ykie-Wang/crkbd/corne-cherry-SMT/corne-smt-gerber/corne-cherry-Edge_Cuts.dxf

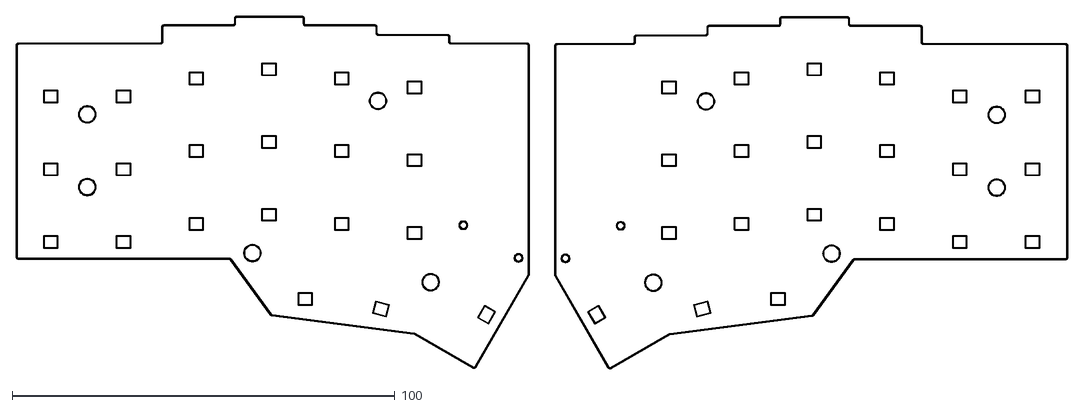
[picture p1: CAD file, 2024-04-05]
corne-cherry-SMT/corne-smt-gerber/corne-cherry-Edge_Cuts.dxf
274.7 x 92.1
