ykie-Wang/crkbd/corne-cherry-SMT/pcb/edges-for-wireless-cherry.dxf

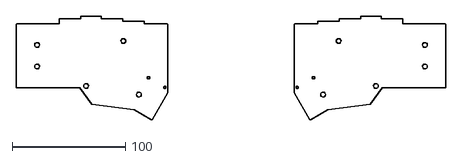
[picture p2: CAD file, 2023-12-01]
corne-cherry-SMT/pcb/edges-for-wireless-cherry.dxf
379.0 x 91.7
