ykie-Wang/crkbd/corne-cherry-SMT/pcb/right-edges-for-wireless-cherry.dxf

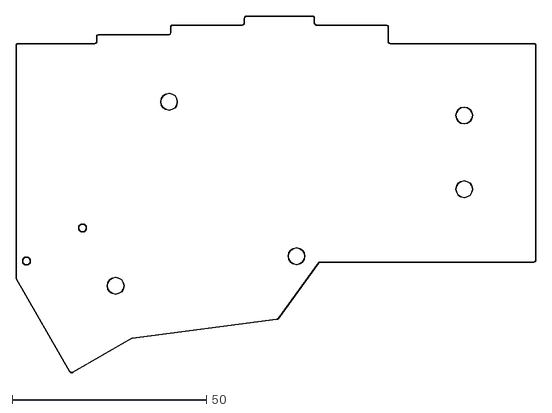
[picture p3: CAD file, 2023-12-01]
corne-cherry-SMT/pcb/right-edges-for-wireless-cherry.dxf
133.8 x 91.7
