ykie-Wang/crkbd/(list of files, cad)

Other CAD files:
corne-cherry-SMT/corne-smt-gerber/corne-cherry-F_Mask.dxf
