ykie-Wang/crkbd/corne-cherry-SMT/pcb/corne-cherry.kicad_pcb

## KiCad design corne-cherry-SMT/pcb/corne-cherry.kicad_pcb (2024-04-05)

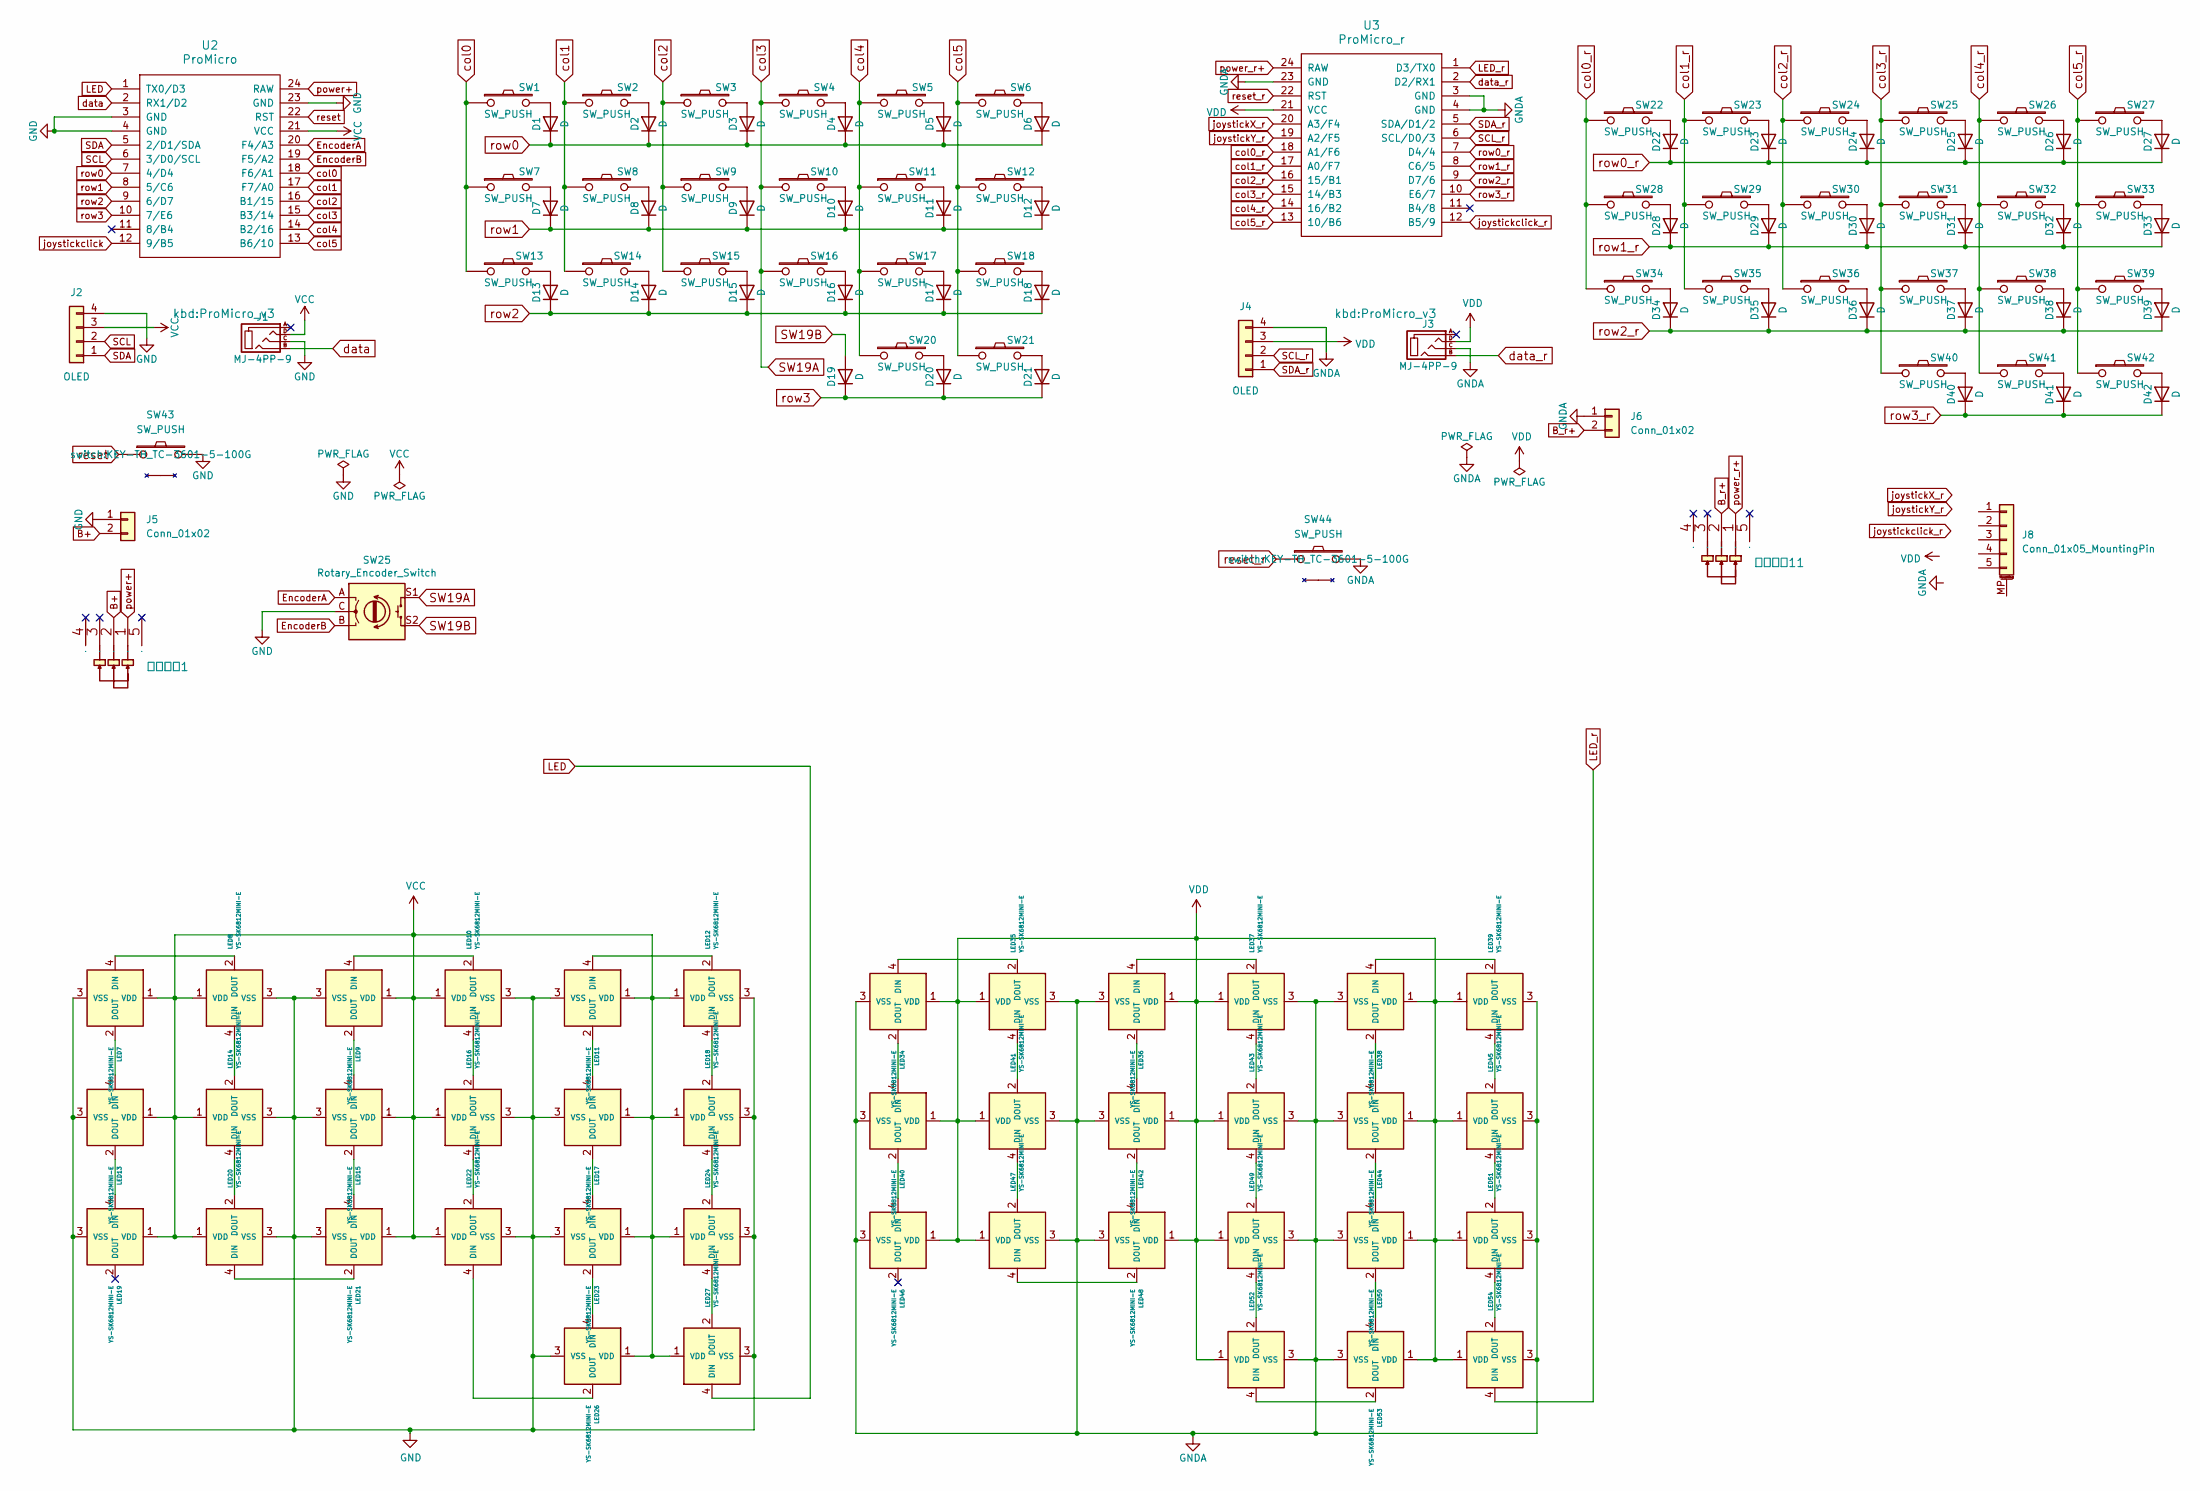
[picture p28: schematic corne-cherry.kicad_sch, Corne Cherry]

Parts:
D1, D2, D3, D4, D5, D6, D7, D8, D9, D10, D11, D12, D13, D14, D15, D16, D17, D18, D19, D20, D21, D22, D23, D24, D25, D26, D27, D28, D29, D30, D31, D32, D33, D34, D35, D36, D37, D38, D39, D40, D41, D42: D; D3_SMD_v2
J1, J3: MJ-4PP-9; MJ-4PP-9_1side
J2, J4: OLED; OLED_1side
J5, J6: Conn_01x02; PinSocket_1x02_P2.54mm_Vertical
J8: Conn_01x05_MountingPin; Molex_200528-0050_1x05-1MP_P1.00mm_Horizontal
LED7, LED8, LED9, LED10, LED11, LED12, LED13, LED14, LED15, LED16, LED17, LED18, LED19, LED20, LED21, LED22, LED23, LED24, LED26, LED27, LED34, LED35, LED36, LED37, LED38, LED39, LED40, LED41, LED42, LED43, LED44, LED45, LED46, LED47, LED48, LED49, LED50, LED51, LED52, LED53, LED54: YS-SK6812MINI-E
SW1, SW2, SW3, SW4, SW5, SW6, SW7, SW8, SW9, SW10, SW11, SW12, SW13, SW14, SW15, SW16, SW17, SW18, SW20, SW22, SW23, SW24, SW25, SW26, SW27, SW28, SW29, SW30, SW31, SW32, SW33, SW34, SW35, SW36, SW37, SW38, SW39, SW40, SW41: SW_PUSH; CherryMX_Hotswap
SW21, SW42: SW_PUSH; CherryMX_Hotswap_1.5u
SW43, SW44: SW_PUSH; KEY-TH_TC-3601-5-100G
U2: ProMicro; ProMicro_v3
U3: ProMicro_r; ProMicro_v3
卧式开关1, 卧式开关11: SW-TH_SK12D07VG5

Connections:
B+: J5.2, 卧式开关1.2
B_r+: J6.2, 卧式开关11.2
EncoderA: SW25.A, U2.20 (F4/A3); also elsewhere on the board
EncoderB: SW25.B, U2.19 (F5/A2); also elsewhere on the board
GND: J1.C, J2.4, J5.1, LED7.3 (VSS), LED8.3 (VSS), LED9.3 (VSS), LED10.3 (VSS), LED11.3 (VSS), LED12.3 (VSS), LED13.3 (VSS), LED14.3 (VSS), LED15.3 (VSS), LED16.3 (VSS), LED17.3 (VSS), LED18.3 (VSS), LED19.3 (VSS), LED20.3 (VSS), LED21.3 (VSS), LED22.3 (VSS), LED23.3 (VSS), LED24.3 (VSS), LED26.3 (VSS), LED27.3 (VSS), SW25.C, SW43.2, U2.3 (GND), U2.4 (GND), U2.23 (GND); also elsewhere on the board
GNDA: J3.C, J4.4, J6.1, LED34.3 (VSS), LED35.3 (VSS), LED36.3 (VSS), LED37.3 (VSS), LED38.3 (VSS), LED39.3 (VSS), LED40.3 (VSS), LED41.3 (VSS), LED42.3 (VSS), LED43.3 (VSS), LED44.3 (VSS), LED45.3 (VSS), LED46.3 (VSS), LED47.3 (VSS), LED48.3 (VSS), LED49.3 (VSS), LED50.3 (VSS), LED51.3 (VSS), LED52.3 (VSS), LED53.3 (VSS), LED54.3 (VSS), SW44.2, U3.3 (GND), U3.4 (GND), U3.23 (GND)
LED: LED27.4 (DIN), U2.1 (TX0/D3); also elsewhere on the board
LED_r: LED54.4 (DIN), U3.1 (D3/TX0)
unnamed: D1.2 (A), SW1.2
unnamed: D2.2 (A), SW2.2
unnamed: D3.2 (A), SW3.2
unnamed: D4.2 (A), SW4.2
unnamed: D5.2 (A), SW5.2
unnamed: D6.2 (A), SW6.2
unnamed: D7.2 (A), SW7.2
unnamed: D8.2 (A), SW8.2
unnamed: D9.2 (A), SW9.2
unnamed: D10.2 (A), SW10.2
unnamed: D11.2 (A), SW11.2
unnamed: D12.2 (A), SW12.2
unnamed: D13.2 (A), SW13.2
unnamed: D14.2 (A), SW14.2
unnamed: D15.2 (A), SW15.2
unnamed: D16.2 (A), SW16.2
unnamed: D17.2 (A), SW17.2
unnamed: D18.2 (A), SW18.2
unnamed: D20.2 (A), SW20.2
unnamed: D21.2 (A), SW21.2
unnamed: D22.2 (A), SW22.2
unnamed: D23.2 (A), SW23.2
unnamed: D24.2 (A), SW24.2
unnamed: D25.2 (A), SW25.2
unnamed: D26.2 (A), SW26.2
unnamed: D27.2 (A), SW27.2
unnamed: D28.2 (A), SW28.2
unnamed: D29.2 (A), SW29.2
unnamed: D30.2 (A), SW30.2
unnamed: D31.2 (A), SW31.2
unnamed: D32.2 (A), SW32.2
unnamed: D33.2 (A), SW33.2
unnamed: D34.2 (A), SW34.2
unnamed: D35.2 (A), SW35.2
unnamed: D36.2 (A), SW36.2
unnamed: D37.2 (A), SW37.2
unnamed: D38.2 (A), SW38.2
unnamed: D39.2 (A), SW39.2
unnamed: D40.2 (A), SW40.2
unnamed: D41.2 (A), SW41.2
unnamed: D42.2 (A), SW42.2
unnamed: LED7.4 (DIN), LED8.2 (DOUT)
unnamed: LED10.4 (DIN), LED16.2 (DOUT)
unnamed: LED9.4 (DIN), LED10.2 (DOUT)
unnamed: LED11.4 (DIN), LED12.2 (DOUT)
unnamed: LED11.2 (DOUT), LED17.4 (DIN)
unnamed: LED12.4 (DIN), LED18.2 (DOUT)
unnamed: LED7.2 (DOUT), LED13.4 (DIN)
unnamed: LED13.2 (DOUT), LED19.4 (DIN)
unnamed: LED14.4 (DIN), LED20.2 (DOUT)
unnamed: LED8.4 (DIN), LED14.2 (DOUT)
unnamed: LED9.2 (DOUT), LED15.4 (DIN)
unnamed: LED15.2 (DOUT), LED21.4 (DIN)
unnamed: LED16.4 (DIN), LED22.2 (DOUT)
unnamed: LED17.2 (DOUT), LED23.4 (DIN)
unnamed: LED18.4 (DIN), LED24.2 (DOUT)
unnamed: LED20.4 (DIN), LED21.2 (DOUT)
unnamed: LED22.4 (DIN), LED26.2 (DOUT)
unnamed: LED23.2 (DOUT), LED26.4 (DIN)
unnamed: LED24.4 (DIN), LED27.2 (DOUT)
unnamed: LED34.4 (DIN), LED35.2 (DOUT)
unnamed: LED34.2 (DOUT), LED40.4 (DIN)
unnamed: LED35.4 (DIN), LED41.2 (DOUT)
unnamed: LED36.4 (DIN), LED37.2 (DOUT)
unnamed: LED36.2 (DOUT), LED42.4 (DIN)
unnamed: LED37.4 (DIN), LED43.2 (DOUT)
unnamed: LED38.4 (DIN), LED39.2 (DOUT)
unnamed: LED38.2 (DOUT), LED44.4 (DIN)
unnamed: LED39.4 (DIN), LED45.2 (DOUT)
unnamed: LED40.2 (DOUT), LED46.4 (DIN)
unnamed: LED41.4 (DIN), LED47.2 (DOUT)
unnamed: LED42.2 (DOUT), LED48.4 (DIN)
unnamed: LED43.4 (DIN), LED49.2 (DOUT)
unnamed: LED44.2 (DOUT), LED50.4 (DIN)
unnamed: LED45.4 (DIN), LED51.2 (DOUT)
unnamed: LED47.4 (DIN), LED48.2 (DOUT)
unnamed: LED49.4 (DIN), LED52.2 (DOUT)
unnamed: LED50.2 (DOUT), LED53.4 (DIN)
unnamed: LED51.4 (DIN), LED54.2 (DOUT)
unnamed: LED52.4 (DIN), LED53.2 (DOUT)
SCL: J2.2, U2.6 (3/D0/SCL); also elsewhere on the board
SCL_r: J4.2, U3.6 (SCL/D0/3)
SDA: J2.1, U2.5 (2/D1/SDA); also elsewhere on the board
SDA_r: J4.1, U3.5 (SDA/D1/2)
SW19A: SW4.1, SW10.1, SW16.1, SW25.S1, U2.15 (B3/14); also elsewhere on the board
SW19B: D19.2 (A), SW25.S2; also elsewhere on the board
VCC: J1.D, J2.3, LED7.1 (VDD), LED8.1 (VDD), LED9.1 (VDD), LED10.1 (VDD), LED11.1 (VDD), LED12.1 (VDD), LED13.1 (VDD), LED14.1 (VDD), LED15.1 (VDD), LED16.1 (VDD), LED17.1 (VDD), LED18.1 (VDD), LED19.1 (VDD), LED20.1 (VDD), LED21.1 (VDD), LED22.1 (VDD), LED23.1 (VDD), LED24.1 (VDD), LED26.1 (VDD), LED27.1 (VDD), U2.21 (VCC); also elsewhere on the board
VDD: J3.D, J4.3, LED34.1 (VDD), LED35.1 (VDD), LED36.1 (VDD), LED37.1 (VDD), LED38.1 (VDD), LED39.1 (VDD), LED40.1 (VDD), LED41.1 (VDD), LED42.1 (VDD), LED43.1 (VDD), LED44.1 (VDD), LED45.1 (VDD), LED46.1 (VDD), LED47.1 (VDD), LED48.1 (VDD), LED49.1 (VDD), LED50.1 (VDD), LED51.1 (VDD), LED52.1 (VDD), LED53.1 (VDD), LED54.1 (VDD), U3.21 (VCC)
col0: SW1.1, SW7.1, SW13.1, U2.18 (F6/A1); also elsewhere on the board
col0_r: SW22.1, SW28.1, SW34.1, U3.18 (A1/F6)
col1: SW2.1, SW8.1, SW14.1, U2.17 (F7/A0); also elsewhere on the board
col1_r: SW23.1, SW29.1, SW35.1, U3.17 (A0/F7)
col2: SW3.1, SW9.1, SW15.1, U2.16 (B1/15); also elsewhere on the board
col2_r: SW24.1, SW30.1, SW36.1, U3.16 (15/B1)
col3_r: SW25.1, SW31.1, SW37.1, SW40.1, U3.15 (14/B3)
col4: SW5.1, SW11.1, SW17.1, SW20.1, U2.14 (B2/16); also elsewhere on the board
col4_r: SW26.1, SW32.1, SW38.1, SW41.1, U3.14 (16/B2)
col5: SW6.1, SW12.1, SW18.1, SW21.1, U2.13 (B6/10); also elsewhere on the board
col5_r: SW27.1, SW33.1, SW39.1, SW42.1, U3.13 (10/B6)
data: J1.B, U2.2 (RX1/D2); also elsewhere on the board
data_r: J3.B, U3.2 (D2/RX1)
joystickX_r: U3.20 (A3/F4)
joystickY_r: U3.19 (A2/F5)
joystickclick: U2.12 (9/B5); also elsewhere on the board
joystickclick_r: U3.12 (B5/9)
power+: U2.24 (RAW), 卧式开关1.1; also elsewhere on the board
power_r+: U3.24 (RAW), 卧式开关11.1
reset: SW43.1, U2.22 (RST); also elsewhere on the board
reset_r: SW44.1, U3.22 (RST)
row0: D1.1 (K), D2.1 (K), D3.1 (K), D4.1 (K), D5.1 (K), D6.1 (K), U2.7 (4/D4); also elsewhere on the board
row0_r: D22.1 (K), D23.1 (K), D24.1 (K), D25.1 (K), D26.1 (K), D27.1 (K), U3.7 (D4/4)
row1: D7.1 (K), D8.1 (K), D9.1 (K), D10.1 (K), D11.1 (K), D12.1 (K), U2.8 (5/C6); also elsewhere on the board
row1_r: D28.1 (K), D29.1 (K), D30.1 (K), D31.1 (K), D32.1 (K), D33.1 (K), U3.8 (C6/5)
row2: D13.1 (K), D14.1 (K), D15.1 (K), D16.1 (K), D17.1 (K), D18.1 (K), U2.9 (6/D7); also elsewhere on the board
row2_r: D34.1 (K), D35.1 (K), D36.1 (K), D37.1 (K), D38.1 (K), D39.1 (K), U3.9 (D7/6)
row3: D19.1 (K), D20.1 (K), D21.1 (K), U2.10 (7/E6); also elsewhere on the board
row3_r: D40.1 (K), D41.1 (K), D42.1 (K), U3.10 (E6/7)

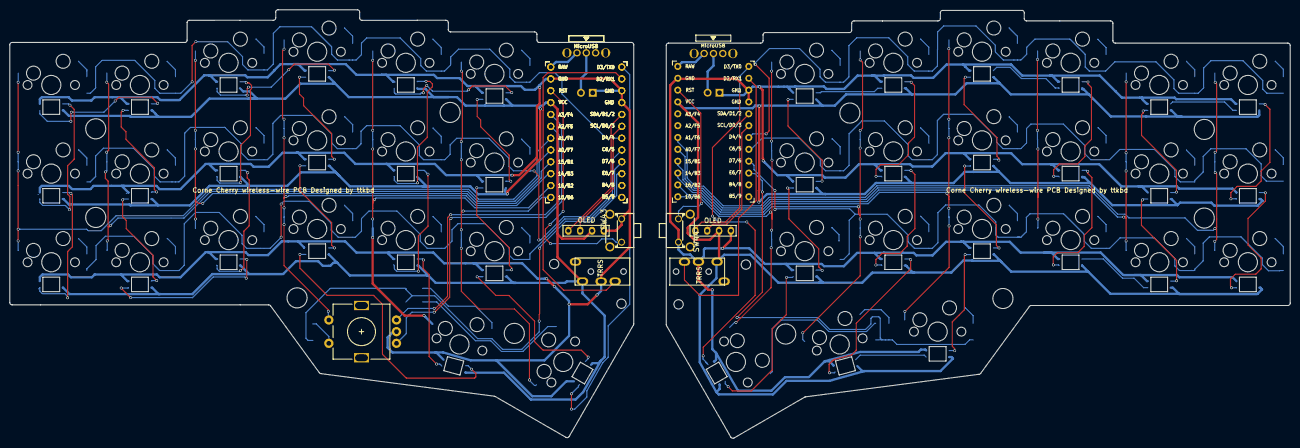
[picture p29: board corne-cherry.kicad_pcb from above]

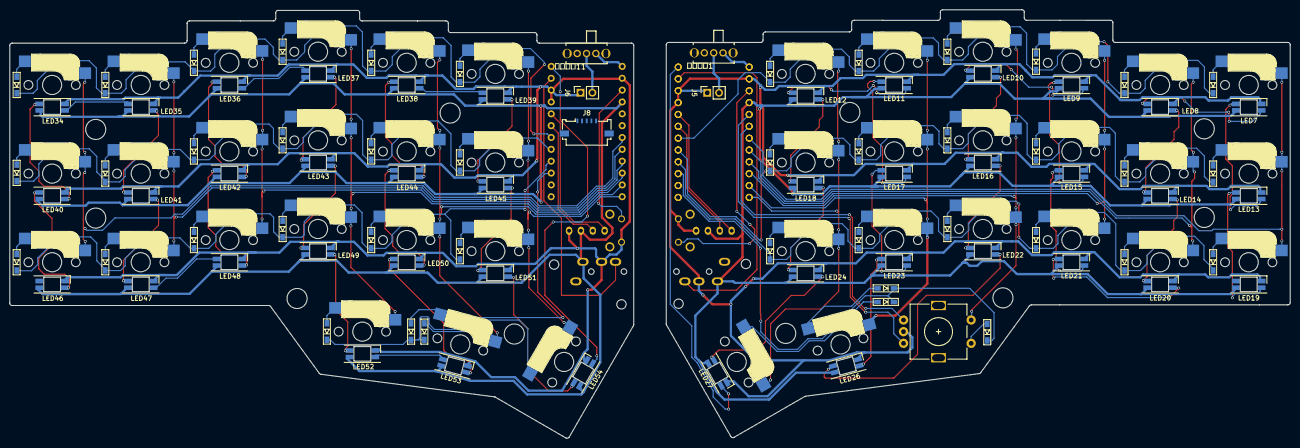
[picture p30: board corne-cherry.kicad_pcb from below]

Board: 2 copper layers, 274.5 x 91.9 mm, 139 parts (88 on the bottom side), 122 nets.

Other parts of the board:
SW45: Rotary_Encoder_Switch; RotaryEncoder_Alps_EC11E-Switch_Vertical_H20mm-keebio_modif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
U2#2: ProMicro; ProMicro_v3

Their connections:
EncoderA: SW45.A, U2#2.20 (F4/A3); also elsewhere on the board
EncoderB: SW45.B, U2#2.19 (F5/A2); also elsewhere on the board
GND: SW45.C, U2#2.3 (GND), U2#2.4 (GND), U2#2.23 (GND); also elsewhere on the board
LED: U2#2.1 (TX0/D3); also elsewhere on the board
SCL: U2#2.6 (3/D0/SCL); also elsewhere on the board
SDA: U2#2.5 (2/D1/SDA); also elsewhere on the board
SW19A: SW45.S1, U2#2.15 (B3/14); also elsewhere on the board
SW19B: SW45.S2; also elsewhere on the board
VCC: U2#2.21 (VCC); also elsewhere on the board
col0: U2#2.18 (F6/A1); also elsewhere on the board
col1: U2#2.17 (F7/A0); also elsewhere on the board
col2: U2#2.16 (B1/15); also elsewhere on the board
col4: U2#2.14 (B2/16); also elsewhere on the board
col5: U2#2.13 (B6/10); also elsewhere on the board
data: U2#2.2 (RX1/D2); also elsewhere on the board
joystickclick: U2#2.12 (9/B5); also elsewhere on the board
power+: U2#2.24 (RAW); also elsewhere on the board
reset: U2#2.22 (RST); also elsewhere on the board
row0: U2#2.7 (4/D4); also elsewhere on the board
row1: U2#2.8 (5/C6); also elsewhere on the board
row2: U2#2.9 (6/D7); also elsewhere on the board
row3: U2#2.10 (7/E6); also elsewhere on the board
