ykie-Wang/crkbd/(commit log)

2023-12-01 Add wireless powers and switches and remove underlights
    [corne-cherry.kicad_pcb, corne-cherry.kicad_sch, edges-for-wireless-cherry.dxf, right-edges-for-wireless-cherry.dxf]
2024-04-05 Fix the `nerdyscout/kicad-exports` schema args
2024-04-05 Upgade `nerdyscout/kicad-exports` to v2.1
2024-04-05 Upgade `nerdyscout/kicad-exports` to v2.2
2024-04-05 Upgade `nerdyscout/kicad-exports` to v2.3
2024-04-05 Switch from `nerdyscout/kicad-exports` to `INTI-CMNB/KiBot`
2024-04-05 Switch `INTI-CMNB/KiBot` to v2_k6
2024-04-05 add joystick
    [corne-cherry-BOM.xlsx, corne-cherry-Edge_Cuts.dxf, corne-cherry-F_Mask.dxf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]
2024-04-05 add rotate encoder in the left
    [corne-cherry.kicad_pcb, corne-cherry.kicad_sch]
